Galacs/stepper-foc-can-1/stepper-foc-can-1.kicad_pcb

## KiCad design stepper-foc-can-1.kicad_pcb (2026-06-30)

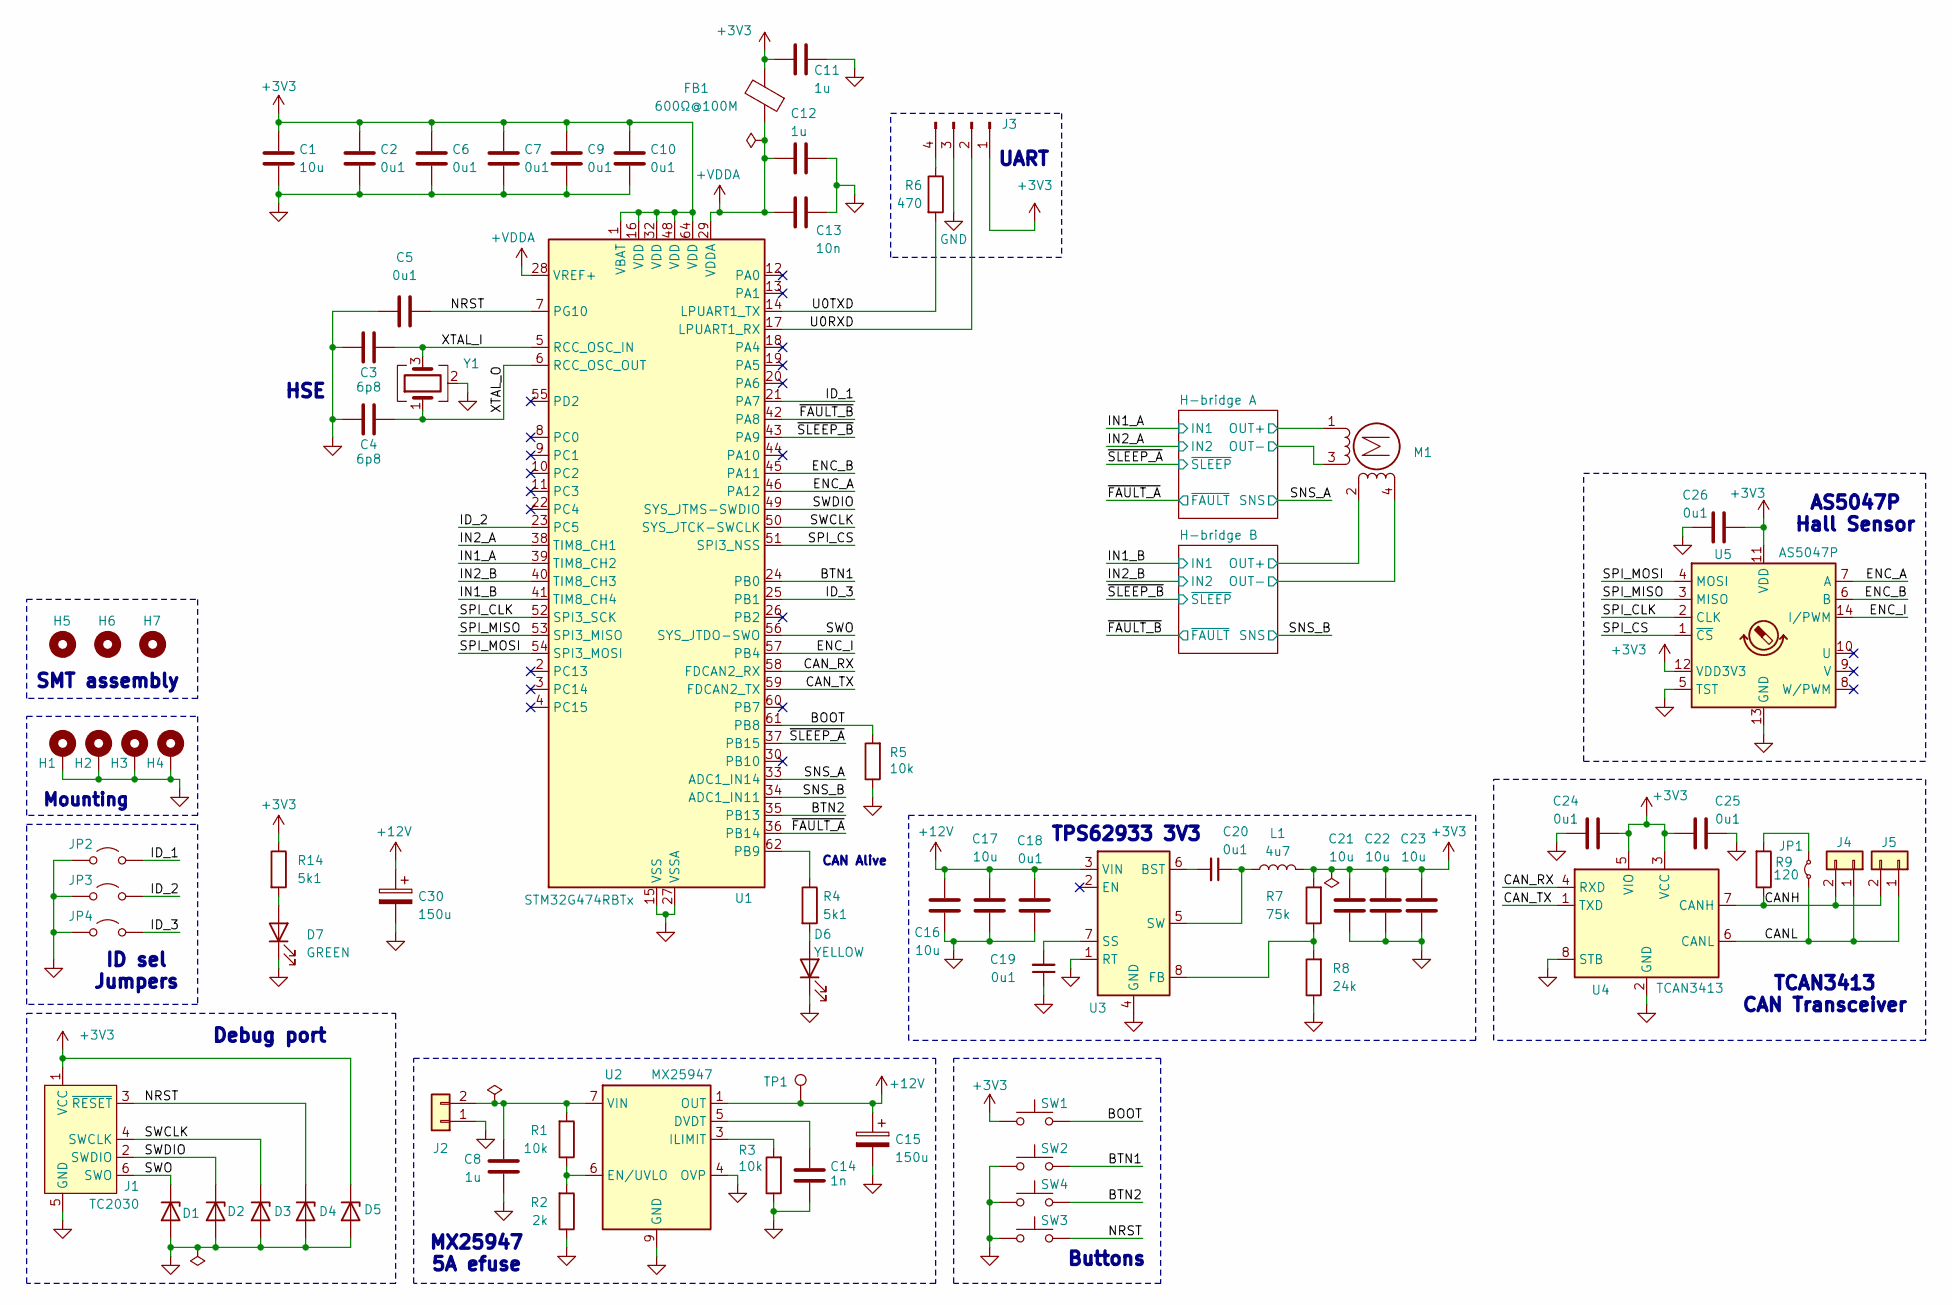
[picture p1: schematic stepper-foc-can-1.kicad_sch, Stepper FOC CAN 1]

Parts:
C1, C16, C17, C21, C22, C23: 10u; C_0805_2012Metric; Manufacturer Part Number GRM21BR61H106KE43L; JLCPCB Part # C440198
C2, C5, C6, C7, C9, C10, C18, C19, C20, C24, C25, C26: 0u1; C_0402_1005Metric; Manufacturer Part Number CL05B104KB54PNC; JLCPCB Part # C307331
C3, C4: 6p8; C_0603_1608Metric; Manufacturer Part Number 0402CG6R8C500NT; JLCPCB Part # C1576
C8, C11, C12: 1u; C_0402_1005Metric; Manufacturer Part Number CL05A105KA5NQNC; JLCPCB Part # C52923
C13: 10n; C_0402_1005Metric; Manufacturer Part Number CL05B103KB5NNNC; JLCPCB Part # C15195
C14: 1n; C_0402_1005Metric; Manufacturer Part Number 0402B102K500NT; JLCPCB Part # C1523
C15, C30: 150u; CP_Elec_6.3x7.7; Manufacturer Part Number EEEFTV151XAP; JLCPCB Part # C178603
D1, D2, D3, D4, D5: H5VU10U; Diode_DFN1006; Manufacturer Part Number H5VU10U; JLCPCB Part # C22395519
D6: YELLOW; LED_0805_2012Metric; Manufacturer Part Number KT-0805Y; JLCPCB Part # C2296
D7: GREEN; LED_0805_2012Metric; Manufacturer Part Number KT-0805G; JLCPCB Part # C2297
FB1: 600Ω@100M; L_0805_2012Metric; Manufacturer Part Number MPZ2012S601ATD25; JLCPCB Part # C81034
H1, H2, H3, H4: MountingHole_Pad; MountingHole_3.2mm_M3_ISO7380_Pad
H5, H6, H7: MountingHole; ToolingHole_1.152mm
J1: TC2030; Tag-Connect_TC2030-IDC-NL_2x03_P1.27mm_Vertical
J2, J4, J5: Conn_01x02; JST_XH_B2B-XH-A_1x02_P2.50mm_Vertical; Manufacturer Part Number B2B-XH-A(LF)(SN); JLCPCB Part # C158012
J3: Conn_01x04_Pin; PinHeader_1x04_P2.54mm_Horizontal
JP1: Jumper_2_Small_Bridged; PinHeader_1x02_P2.54mm_Horizontal
JP2, JP3, JP4: Jumper_2_Open; SolderJumper-2_P1.3mm_Open_RoundedPad1.0x1.5mm
L1: 4u7; L_1008_2520Metric; Manufacturer Part Number FTC252010S4R7MBCA; JLCPCB Part # C5832360
M1: Stepper_Motor_bipolar; JST_XH_S4B-XH-A_1x04_P2.50mm_Horizontal
R1, R3, R5: 10k; R_0402_1005Metric; Manufacturer Part Number 0402WGF1002TCE; JLCPCB Part # C25744
R2: 2k; R_0402_1005Metric; Manufacturer Part Number 0402WGF2001TCE; JLCPCB Part # C4109
R4, R14: 5k1; R_0402_1005Metric; Manufacturer Part Number 0402WGF5101TCE; JLCPCB Part # C25905
R6: 470; R_0402_1005Metric; Manufacturer Part Number 0402WGF4700TCE; JLCPCB Part # C25117
R7: 75k; R_0402_1005Metric; Manufacturer Part Number 0402WGF7502TCE; JLCPCB Part # C25798
R8: 24k; R_0402_1005Metric; Manufacturer Part Number 0402WGF2402TCE; JLCPCB Part # C25769
R9: 120; R_1206_3216Metric; Manufacturer Part Number 1206W4F1200T5E; JLCPCB Part # C17909
SW1, SW2, SW3, SW4: SW_Push; SW_SPST_TS-1088-xR020; Manufacturer Part Number TS-1088-AR02016; JLCPCB Part # C720477
TP1: TestPoint; TestPoint_Pad_D2.0mm
U1: STM32G474RBTx; LQFP-64_10x10mm_P0.5mm; Manufacturer Part Number STM32G474RBT3; JLCPCB Part # C1235414
U2: MX25947; TI_SO-PowerPAD-8_ThermalVias; Manufacturer Part Number MX25947ES; JLCPCB Part # C5875698
U3: TPS62933; SOT-583-8; Manufacturer Part Number TPS62933DRLR; JLCPCB Part # C3200405
U4: TCAN3413; TSOT-23-8; Manufacturer Part Number TCAN3413DDFR; JLCPCB Part # C30111221
U5: AS5047P; TSSOP-14_4.4x5mm_P0.65mm; Manufacturer Part Number AS5047P-ATSM; JLCPCB Part # C962063
Y1: Crystal_GND24; Crystal_SMD_2016-4Pin_2.0x1.6mm; Manufacturer Part Number XTM20024000DT00351001; JLCPCB Part # C37635325

Connections:
+3V3: C1.1, C2.1, C6.1, C7.1, C9.1, C10.1, C11.1, C21.1, C22.1, C23.1, C24.1, C25.1, C26.1, D5.1 (K), FB1.2, J1.1 (VCC), J3.1, L1.2, R7.2, R14.1, SW1.1, U1.1 (VBAT), U1.16 (VDD), U1.32 (VDD), U1.48 (VDD), U1.64 (VDD), U4.3 (VCC), U4.5 (VIO), U5.11 (VDD), U5.12 (VDD3V3); also elsewhere on the board
+12V: C15.1, C16.1, C17.1, C18.1, C30.1, TP1.1 (1_1), U2.1 (OUT), U2.2 (OUT), U3.3 (VIN); also elsewhere on the board
+VDDA: C12.1, C13.1, FB1.1, U1.28 (VREF+), U1.29 (VDDA); also elsewhere on the board
/BOOT: R5.2, SW1.2, U1.61 (PB8)
/BTN1: SW2.2, U1.24 (PB0)
/BTN2: SW4.2, U1.35 (PB13)
/CANH: J4.2, J5.2, R9.1, U4.7 (CANH)
/CANL: J4.1, J5.1, JP1.1 (A), U4.6 (CANL)
/CAN_RX: U1.58 (FDCAN2_RX), U4.4 (RXD)
/CAN_TX: U1.59 (FDCAN2_TX), U4.1 (TXD)
/ENC_A: U1.46 (PA12), U5.7 (A)
/ENC_B: U1.45 (PA11), U5.6 (B)
/ENC_I: U1.57 (PB4), U5.14 (I/PWM)
/H-bridge A/OUT+: M1.1 (-_1); also elsewhere on the board
/H-bridge A/OUT-: M1.3; also elsewhere on the board
/H-bridge B/OUT+: M1.2; also elsewhere on the board
/H-bridge B/OUT-: M1.4; also elsewhere on the board
/ID_1: JP2.2 (B), U1.21 (PA7)
/ID_2: JP3.2 (B), U1.23 (PC5)
/ID_3: JP4.2 (B), U1.25 (PB1)
/IN1_A: U1.39 (TIM8_CH2); also elsewhere on the board
/IN1_B: U1.41 (TIM8_CH4); also elsewhere on the board
/IN2_A: U1.38 (TIM8_CH1); also elsewhere on the board
/IN2_B: U1.40 (TIM8_CH3); also elsewhere on the board
/NRST: C5.2, D4.1 (K), J1.3 (~RESET), SW3.2, U1.7 (PG10)
/SNS_A: U1.33 (ADC1_IN14); also elsewhere on the board
/SNS_B: U1.34 (ADC1_IN11); also elsewhere on the board
/SPI_CLK: U1.52 (SPI3_SCK), U5.2 (CLK)
/SPI_CS: U1.51 (SPI3_NSS), U5.1 (~CS)
/SPI_MISO: U1.53 (SPI3_MISO), U5.3 (MISO)
/SPI_MOSI: U1.54 (SPI3_MOSI), U5.4 (MOSI)
/SWCLK: D3.1 (K), J1.4 (SWCLK), U1.50 (SYS_JTCK-SWCLK)
/SWDIO: D2.1 (K), J1.2 (SWDIO), U1.49 (SYS_JTMS-SWDIO)
/SWO: D1.1 (K), J1.6 (SWO), U1.56 (SYS_JTDO-SWO)
/U0RXD: J3.2, U1.17 (LPUART1_RX)
/U0TXD: R6.2, U1.14 (LPUART1_TX)
/XTAL_I: C3.1, U1.5 (RCC_OSC_IN), Y1.3
/XTAL_O: C4.1, U1.6 (RCC_OSC_OUT), Y1.1
/~FAULT_A: U1.36 (PB14); also elsewhere on the board
/~FAULT_B: U1.42 (PA8); also elsewhere on the board
/~SLEEP_A: U1.37 (PB15); also elsewhere on the board
/~SLEEP_B: U1.43 (PA9); also elsewhere on the board
GND: C1.2, C2.2, C3.2, C4.2, C5.1, C6.2, C7.2, C8.1, C9.2, C10.2, C11.2, C12.2, C13.2, C14.2, C15.2, C16.2, C17.2, C18.2, C19.1, C21.2, C22.2, C23.2, C24.2, C25.2, C26.2, C30.2, D1.2 (A), D2.2 (A), D3.2 (A), D4.2 (A), D5.2 (A), D6.1 (K), D7.1 (K), H1.1 (1_1), H2.1 (1_1), H3.1 (1_1), H4.1 (1_1), J1.5 (GND), J2.1, J3.3, JP2.1 (A), JP3.1 (A), JP4.1 (A), R2.1, R3.1, R5.1, R8.1, SW2.1, SW3.1, SW4.1, U1.15 (VSS), U1.27 (VSSA), U1.31 (VSS), U1.47 (VSS), U1.63 (VSS), U2.4 (OVP), U2.9 (GND), U3.1 (RT), U3.4 (GND), U4.2 (GND), U4.8 (STB), U5.5 (TST), U5.13 (GND), Y1.2 (G), Y1.4 (G); also elsewhere on the board
unnamed: D6.2 (A), R4.2
unnamed: D7.2 (A), R14.2
unnamed: J3.4, R6.1
unnamed: JP1.2 (B), R9.2
unnamed: R4.1, U1.62 (PB9)
unnamed: C14.1, U2.5 (DVDT)
unnamed: R1.1, R2.2, U2.6 (EN/UVLO)
unnamed: R3.2, U2.3 (ILIMIT)
unnamed: C20.2, U3.6 (BST)
unnamed: R7.1, R8.2, U3.8 (FB)
unnamed: C19.2, U3.7 (SS)
unnamed: C20.1, L1.1, U3.5 (SW)
VIN: C8.2, J2.2, R1.2, U2.7 (VIN), U2.8 (VIN)

Notes on the sheet:
Mounting
AS5047P Hall Sensor
TPS62933 3V3
CAN Alive
UART
MX25947 5A efuse
SMT assembly
HSE
TCAN3413 CAN Transceiver
Buttons
Debug port
ID sel Jumpers

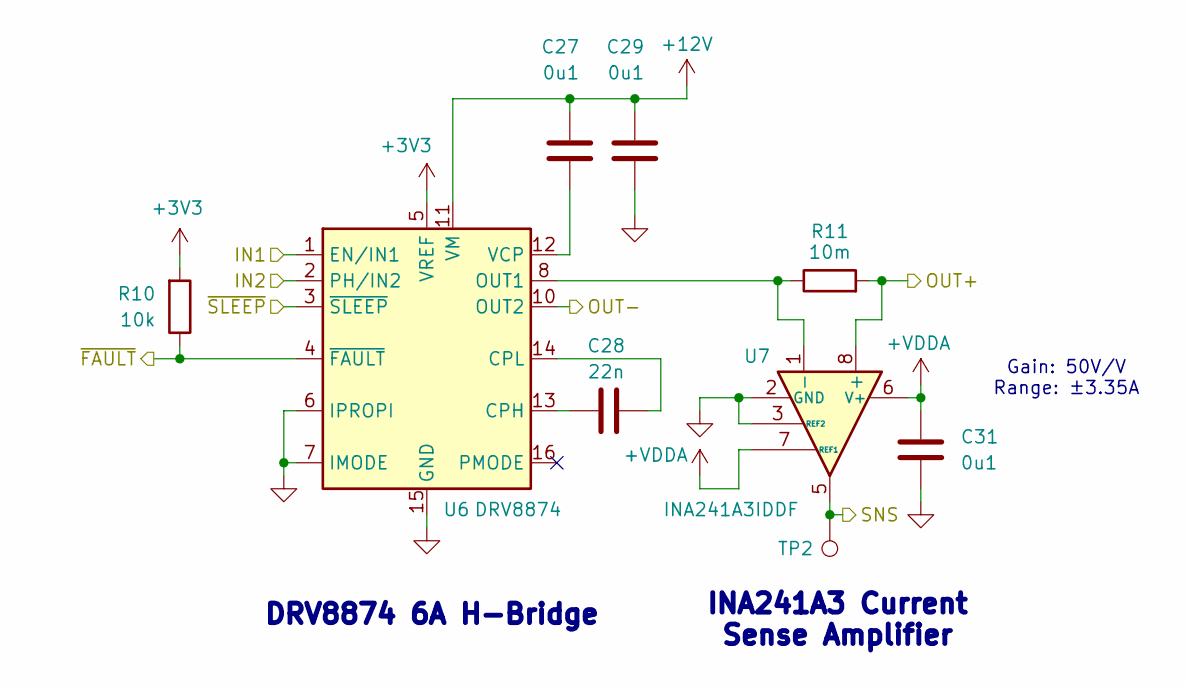
[picture p2: schematic h-bridge.kicad_sch, Stepper FOC CAN 1]

Parts:
C27, C29, C31: 0u1; C_0402_1005Metric; Manufacturer Part Number CL05B104KB54PNC; JLCPCB Part # C307331
C28: 22n; C_0402_1005Metric; Manufacturer Part Number 0402B223K500NT; JLCPCB Part # C1532
R10: 10k; R_0402_1005Metric; Manufacturer Part Number 0402WGF1002TCE; JLCPCB Part # C25744
R11: 10m; R_0805_2012Metric; Manufacturer Part Number HoYLR0805-1/2W-10mR-1%; JLCPCB Part # C22450688
TP2: TestPoint; TestPoint_Pad_D2.0mm
U6: DRV8874; HTSSOP-16-1EP_4.4x5mm_P0.65mm_EP3.4x5mm_Mask2.46x2.31mm_The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; Manufacturer Part Number DRV8874PWPR; JLCPCB Part # C1855818
U7: INA241A3IDDF; SOT-23-8; Manufacturer Part Number INA241A3IDDFR; JLCPCB Part # C6051860

Connections:
+3V3: R10.2, U6.5 (VREF); also elsewhere on the board
+12V: C27.1, C29.1, U6.11 (VM); also elsewhere on the board
+VDDA: C31.1, U7.6 (V+), U7.7 (REF1); also elsewhere on the board
/H-bridge A/OUT+: R11.2, U7.8 (+); also elsewhere on the board
/H-bridge A/OUT-: U6.10 (OUT2); also elsewhere on the board
/IN1_A: U6.1 (EN/IN1); also elsewhere on the board
/IN2_A: U6.2 (PH/IN2); also elsewhere on the board
/SNS_A: TP2.1 (1_1), U7.5; also elsewhere on the board
/~FAULT_A: R10.1, U6.4 (~FAULT); also elsewhere on the board
/~SLEEP_A: U6.3 (~SLEEP); also elsewhere on the board
GND: C29.2, C31.2, U6.6 (IPROPI), U6.7 (IMODE), U6.9 (PGND), U6.15 (GND), U6.17 (EPAD), U7.2 (GND), U7.3 (REF2), U7.4 (GND); also elsewhere on the board
unnamed: C28.1, U6.13 (CPH)
unnamed: C28.2, U6.14 (CPL)
unnamed: R11.1, U6.8 (OUT1), U7.1 (-)
unnamed: C27.2, U6.12 (VCP)

Parts of its further copies:
C32, C34, C36: 0u1; C_0402_1005Metric; Manufacturer Part Number CL05B104KB54PNC; JLCPCB Part # C307331
C33: 22n; C_0402_1005Metric; Manufacturer Part Number 0402B223K500NT; JLCPCB Part # C1532
R12: 10k; R_0402_1005Metric; Manufacturer Part Number 0402WGF1002TCE; JLCPCB Part # C25744
R13: 10m; R_0805_2012Metric; Manufacturer Part Number HoYLR0805-1/2W-10mR-1%; JLCPCB Part # C22450688
TP3: TestPoint; TestPoint_Pad_D2.0mm
U8: DRV8874; HTSSOP-16-1EP_4.4x5mm_P0.65mm_EP3.4x5mm_Mask2.46x2.31mm_The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; Manufacturer Part Number DRV8874PWPR; JLCPCB Part # C1855818
U9: INA241A3IDDF; SOT-23-8; Manufacturer Part Number INA241A3IDDFR; JLCPCB Part # C6051860

Connections of its further copies:
+3V3: R12.2, U8.5 (VREF); also elsewhere on the board
+12V: C32.1, C34.1, U8.11 (VM); also elsewhere on the board
+VDDA: C36.1, U9.6 (V+), U9.7 (REF1); also elsewhere on the board
/H-bridge B/OUT+: R13.2, U9.8 (+); also elsewhere on the board
/H-bridge B/OUT-: U8.10 (OUT2); also elsewhere on the board
/IN1_B: U8.1 (EN/IN1); also elsewhere on the board
/IN2_B: U8.2 (PH/IN2); also elsewhere on the board
/SNS_B: TP3.1 (1_1), U9.5; also elsewhere on the board
/~FAULT_B: R12.1, U8.4 (~FAULT); also elsewhere on the board
/~SLEEP_B: U8.3 (~SLEEP); also elsewhere on the board
GND: C34.2, C36.2, U8.6 (IPROPI), U8.7 (IMODE), U8.9 (PGND), U8.15 (GND), U8.17 (EPAD), U9.2 (GND), U9.3 (REF2), U9.4 (GND); also elsewhere on the board
unnamed: C33.1, U8.13 (CPH)
unnamed: C33.2, U8.14 (CPL)
unnamed: R13.1, U8.8 (OUT1), U9.1 (-)
unnamed: C32.2, U8.12 (VCP)

Notes on the sheet:
Gain: 50V/V Range: ±3.35A
INA241A3 Current Sense Amplifier
DRV8874 6A H-Bridge

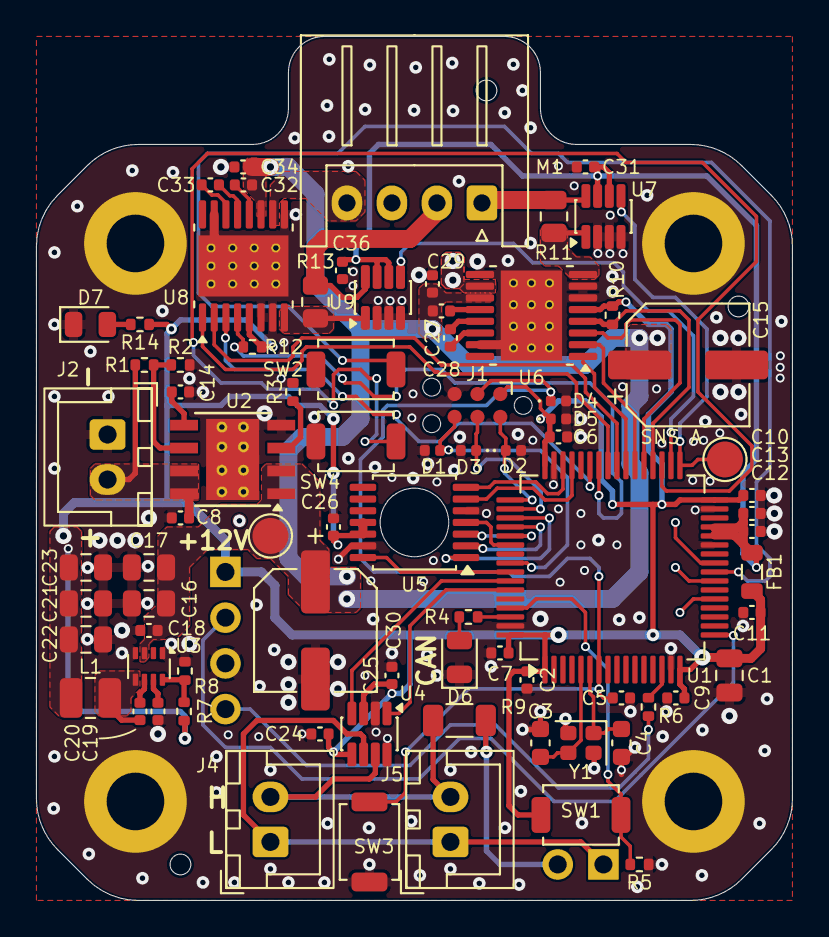
[picture p3: board stepper-foc-can-1.kicad_pcb from above]

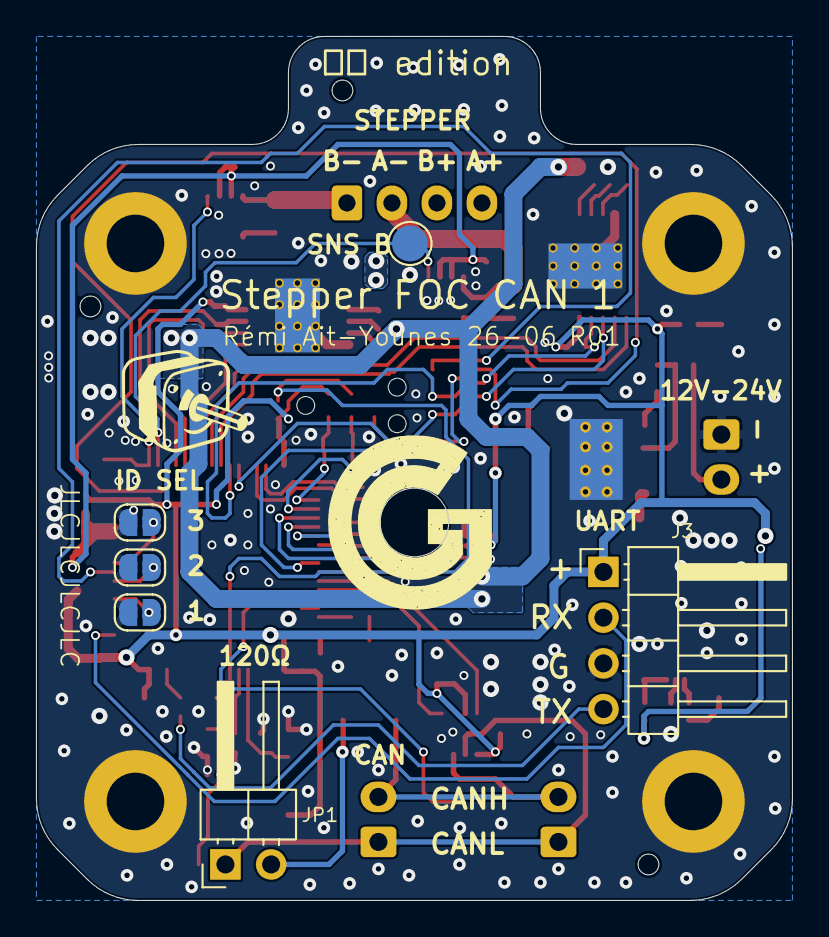
[picture p4: board stepper-foc-can-1.kicad_pcb from below]

Board: 4 copper layers, 42.0 x 48.0 mm, 92 parts (6 on the bottom side), 64 nets.
