Galacs/stepper-foc-can-1/(commit log)

2026-06-29 schem: add stm32g474
    [stepper-foc-can-1.kicad_sch]
2026-06-29 schem: add stm32 decoupling caps
    [stepper-foc-can-1.kicad_sch]
2026-06-29 schem: add hse and reset
    [stepper-foc-can-1.kicad_sch]
2026-06-29 schem: add boot
    [stepper-foc-can-1.kicad_sch]
2026-06-29 schem: add tc2030 swd connector
    [stepper-foc-can-1.kicad_sch]
2026-06-29 schem: add MX25947 5A efuse
    [stepper-foc-can-1.kicad_sch]
2026-06-29 schem: add uart connctor
    [stepper-foc-can-1.kicad_sch]
2026-06-29 schem: fix uart pins
    [stepper-foc-can-1.kicad_sch]
2026-06-29 schem: import TCAN3413 CAN Transceiver
    [stepper-foc-can-1.kicad_sch]
2026-06-29 schem: add btns
    [stepper-foc-can-1.kicad_sch]
2026-06-29 schem: add TPS62933 3V3 buck
    [stepper-foc-can-1.kicad_sch]
2026-06-29 schem: add AS5047P Hall Sensor
    [stepper-foc-can-1.kicad_sch]
2026-06-29 schem: add can led
    [stepper-foc-can-1.kicad_sch]
2026-06-29 schem: add DRV8874 h bridge driver
    [stepper-foc-can-1.kicad_sch]
2026-06-29 schem: add INA241A ultra precision current sense amp
    [stepper-foc-can-1.kicad_sch]
2026-06-29 schem: add second h bridge and motor connector
    [h-bridge.kicad_sch, stepper-foc-can-1.kicad_sch]
2026-06-29 schem: connect h bridges to mcu
    [stepper-foc-can-1.kicad_sch]
2026-06-29 schem: add no connects
    [stepper-foc-can-1.kicad_sch]
2026-06-29 schem: run and fix ERC
    [stepper-foc-can-1.kicad_sch]
2026-06-29 schem: add missing footprints
    [h-bridge.kicad_sch, stepper-foc-can-1.kicad_sch]
2026-06-29 schem: add ordering info to BOM
    [h-bridge.kicad_sch, stepper-foc-can-1.kicad_sch]
2026-06-29 schem: add title
    [h-bridge.kicad_sch, stepper-foc-can-1.kicad_sch]
2026-06-29 schem: reannotate
    [h-bridge.kicad_sch, stepper-foc-can-1.kicad_sch]
2026-06-29 schem: add mounting holes
    [stepper-foc-can-1.kicad_sch]
2026-06-29 pcb: import jlc 4 layer stackup
    [stepper-foc-can-1.kicad_pcb]
2026-06-29 pcb: import footprints from schem
    [stepper-foc-can-1.kicad_pcb]
2026-06-29 pcb: fix missing 3d models
    [stepper-foc-can-1.kicad_pcb]
2026-06-29 pcb: add board outline
    [stepper-foc-can-1.kicad_pcb]
2026-06-29 pcb: add can layout
    [stepper-foc-can-1.kicad_pcb]
2026-06-29 pcb: add hall sensor layout
    [stepper-foc-can-1.kicad_pcb]
2026-06-29 pcb: add efuse layout
    [stepper-foc-can-1.kicad_pcb]
2026-06-29 pcb: add smps layout
    [stepper-foc-can-1.kicad_pcb]
2026-06-29 pcb: add stm32 layout
    [stepper-foc-can-1.kicad_pcb]
2026-06-29 schem: update 22n capacitor PN
    [h-bridge.kicad_sch]
2026-06-29 pcb: add stepper drvs layout
    [stepper-foc-can-1.kicad_pcb]
2026-06-29 schem: update mounting holes footprint
    [stepper-foc-can-1.kicad_sch]
2026-06-29 pcb: add drvs placement
    [h-bridge.kicad_sch, stepper-foc-can-1.kicad_pcb, stepper-foc-can-1.kicad_sch]
2026-06-29 pcb: add stm32 placement
    [stepper-foc-can-1.kicad_pcb]
2026-06-30 schem/pcb: fix caps
    [stepper-foc-can-1.kicad_pcb, stepper-foc-can-1.kicad_sch]
2026-06-30 schem/pcb: add tooling holes
    [stepper-foc-can-1.kicad_pcb, stepper-foc-can-1.kicad_sch]
2026-06-30 pcb: add gnd planes
    [stepper-foc-can-1.kicad_pcb]
2026-06-30 pcb: add gnd vias
    [stepper-foc-can-1.kicad_pcb]
2026-06-30 pcb: add drill/place origin
    [stepper-foc-can-1.kicad_pcb]
2026-06-30 schem: reorganize programmable gpios
    [stepper-foc-can-1.kicad_pcb, stepper-foc-can-1.kicad_sch]
2026-06-30 pcb: add xtal routing
    [stepper-foc-can-1.kicad_pcb]
2026-06-30 pcb: add SPI routing
    [stepper-foc-can-1.kicad_pcb]
2026-06-30 pcb: add can routing
    [stepper-foc-can-1.kicad_pcb]
2026-06-30 pcb: add pwm routing
    [stepper-foc-can-1.kicad_pcb]
2026-06-30 pcb: route analog current sense
    [stepper-foc-can-1.kicad_pcb]
2026-06-30 pcb: add swd routing
    [stepper-foc-can-1.kicad_pcb]
2026-06-30 pcb: route encoder
    [stepper-foc-can-1.kicad_pcb]
2026-06-30 pcb: add efuse routing
    [stepper-foc-can-1.kicad_pcb]
2026-06-30 pcb: add smps routing
    [stepper-foc-can-1.kicad_pcb]
2026-06-30 pcb: add +12v and drvs routing
    [stepper-foc-can-1.kicad_pcb]
2026-06-30 pcb: add drv sleep/fault routing
    [stepper-foc-can-1.kicad_pcb]
2026-06-30 pcb: add +3v3 pwr routing
    [stepper-foc-can-1.kicad_pcb, stepper-foc-can-1.kicad_sch]
2026-06-30 pcb: route vref
    [stepper-foc-can-1.kicad_pcb]
2026-06-30 pcb: route nrst
    [stepper-foc-can-1.kicad_pcb]
2026-06-30 schem: add id selection jumpers 3bit
    [stepper-foc-can-1.kicad_sch]
2026-06-30 pcb: route id jumpers
    [stepper-foc-can-1.kicad_pcb]
2026-06-30 pcb: add uart routing
    [stepper-foc-can-1.kicad_pcb]
2026-06-30 pcb: add painful btns routing
    [stepper-foc-can-1.kicad_pcb, stepper-foc-can-1.kicad_sch]
2026-06-30 pcb: route missing +12v
    [stepper-foc-can-1.kicad_pcb]
2026-06-30 pcb: add stitching vias
    [stepper-foc-can-1.kicad_pcb]
2026-06-30 pcb: run and fix DRC
    [stepper-foc-can-1.kicad_pcb]
2026-06-30 pcb: remove unused internal pads
    [stepper-foc-can-1.kicad_pcb]
2026-06-30 pcb(silk): clean reference designators
    [stepper-foc-can-1.kicad_pcb]
2026-06-30 schem: add +3v3 status led
    [stepper-foc-can-1.kicad_sch]
2026-06-30 pcb(silk): add user txt
    [stepper-foc-can-1.kicad_pcb]
2026-06-30 pcb: add title
    [stepper-foc-can-1.kicad_pcb]
2026-06-30 generate production files
    [bom.csv, designators.csv, positions.csv]
